beacon1096/rtx-a2000-single-slot-full-height-bracket/models/a2000-full-height-v4-assembly.stl

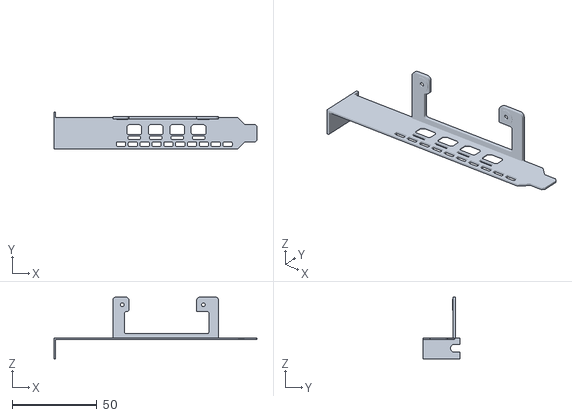
[picture p2: CAD file, 2026-11-06]
models/a2000-full-height-v4-assembly.stl
120.0 x 21.6 x 36.6
