beacon1096/rtx-a2000-single-slot-full-height-bracket/(list of files, cad)

Other CAD files:
models/a2000-full-height-v4-print.3mf
models/a2000-full-height-v4-print.stl
